RobinBaruffa/omniPTT-hardware/Kicad_import_LCSC.md

easyeda2kicad --full --lcsc_id=XXXXXXX --output /home/robin/Projects/OmniPTT/hardware/libraries/Project_components.kicad_sym
