RobinBaruffa/omniPTT-hardware/ptt_board/ptt_board_core/exports/3D_model/ptt_board_core.step

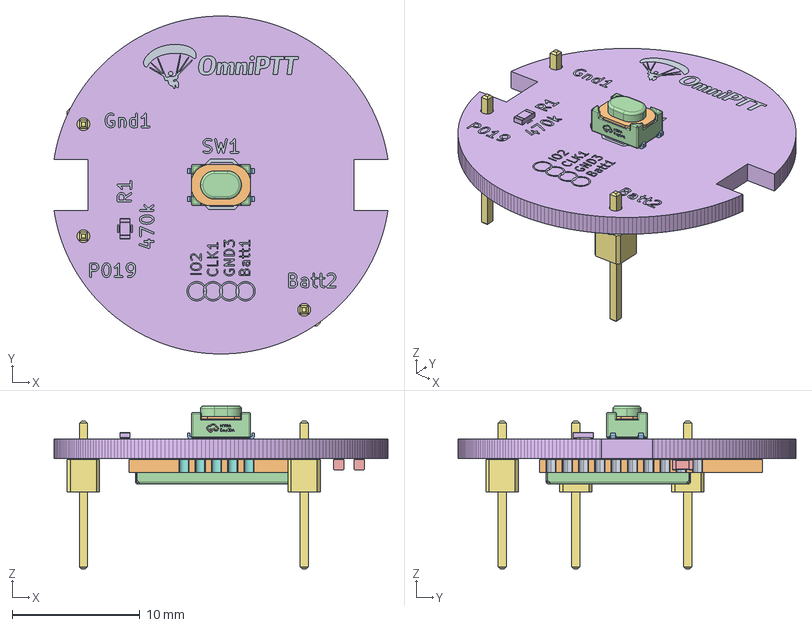
[picture p1: CAD file, 2026-05-04]
ptt_board/ptt_board_core/exports/3D_model/ptt_board_core.step
26.1 x 26.4 x 12.7 mm
SW-SMD_4P-L4.2-W3.2-P2.15-LS4.6
R_0603_1608Metric
PinHeader_1x01_P2.54mm_Vertical x 3
SKB369
C_0603_1608Metric x 2
ptt_board_core_silkscreen x 2
ptt_board_core_PCB
