RobinBaruffa/omniPTT-hardware/radio_board/exports/3D_model/ptt_board_cell.step

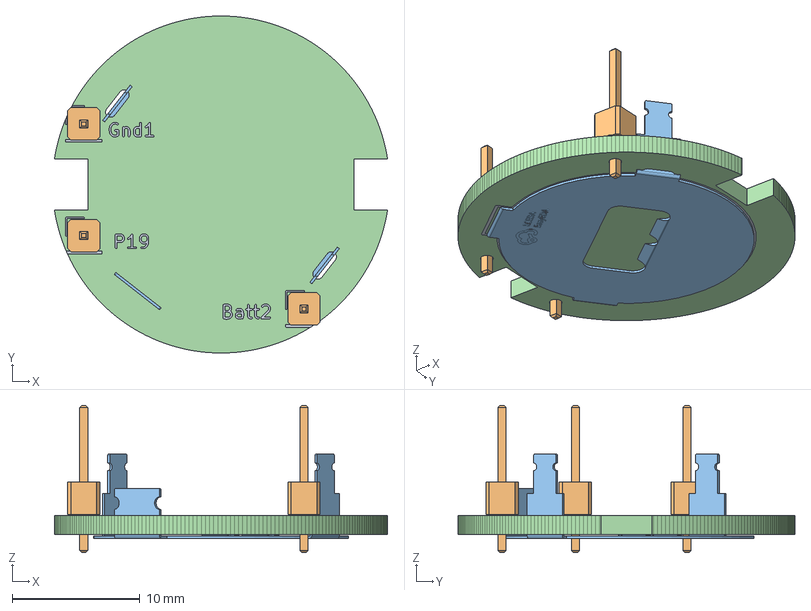
[picture p2: CAD file, 2026-05-04]
radio_board/exports/3D_model/ptt_board_cell.step
26.1 x 26.4 x 11.5 mm
PinHeader_1x01_P2.54mm_Vertical x 3
BATT-TH_MY-2032-02
ptt_board_cell_silkscreen x 2
ptt_board_cell_PCB
