RobinBaruffa/omniPTT-hardware/ptt_board/ptt_board_core/ptt_board_core.kicad_pcb

## KiCad design ptt_board/ptt_board_core/ptt_board_core.kicad_pcb (2026-05-04)

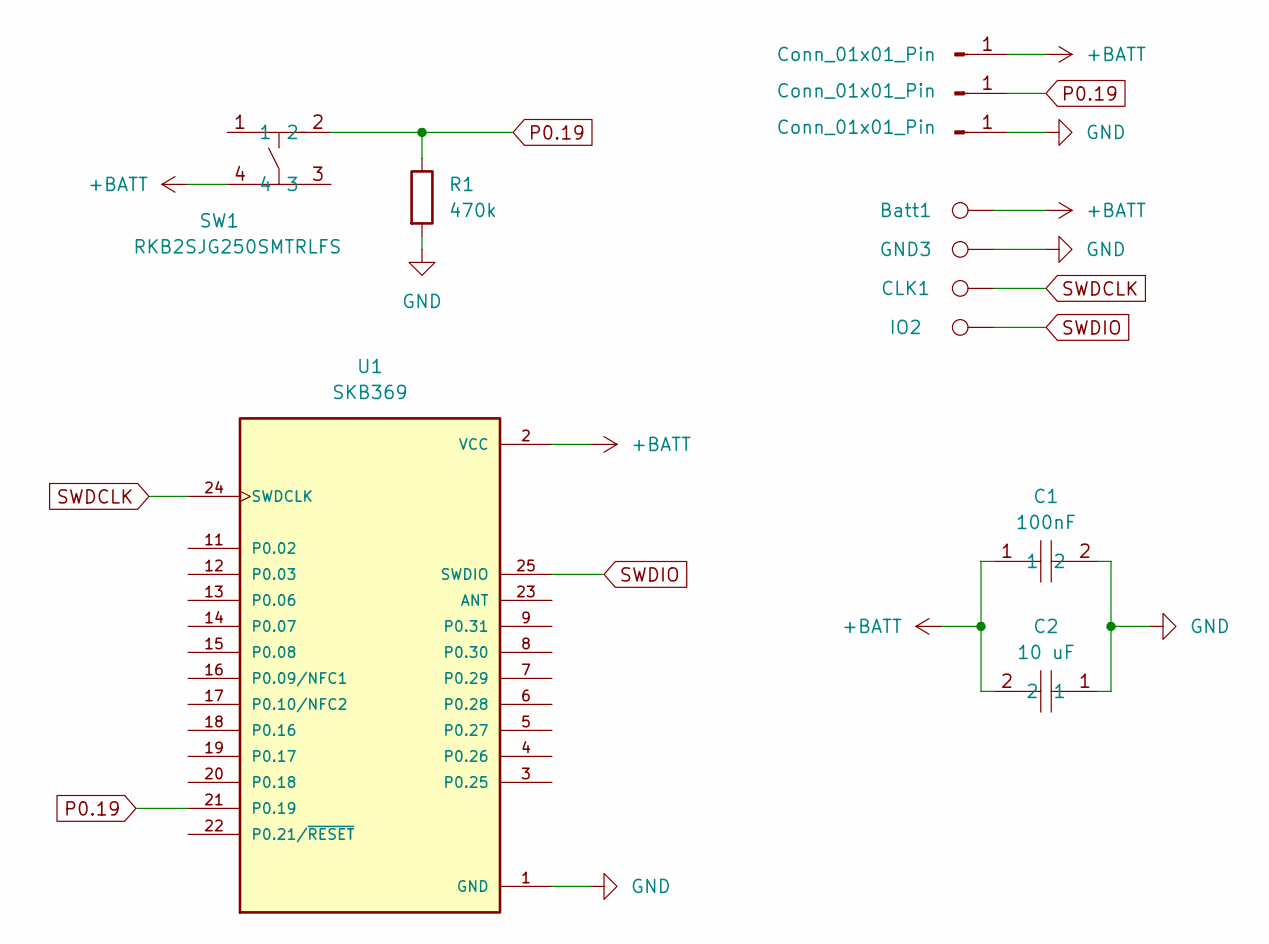
[picture p3: schematic ptt_board_core.kicad_sch]

Parts:
Batt1: TestPoint; TestPoint_Pad_D1.0mm
Batt2: Conn_01x01_Pin; PinHeader_1x01_P2.54mm_Vertical
C1: 100nF; C_0603_1608Metric_Pad1.08x0.95mm_HandSolder; LCSC Part C14663
C2: 10 uF; C_0603_1608Metric_Pad1.08x0.95mm_HandSolder; LCSC Part C14663
CLK1: TestPoint; TestPoint_Pad_D1.0mm
GND3: TestPoint; TestPoint_Pad_D1.0mm
Gnd1: Conn_01x01_Pin; PinHeader_1x01_P2.54mm_Vertical
IO2: TestPoint; TestPoint_Pad_D1.0mm
P019: Conn_01x01_Pin; PinHeader_1x01_P2.54mm_Vertical
R1: 470k; R_0603_1608Metric_Pad0.98x0.95mm_HandSolder; LCSC Part C114622
SW1: RKB2SJG250SMTRLFS; Push button C2927788; LCSC Part C2927788
U1: SKB369; SKYLAB_SKB369; PART_REV V1.03

Connections:
+BATT: Batt1.1, Batt2.1, C1.1, C2.2, SW1.4, U1.2 (VCC)
GND: C1.2, C2.1, GND3.1, Gnd1.1, R1.2, U1.1 (GND), U1.10 (GND)
P0.19: P019.1, R1.1, SW1.2, U1.21 (P0.19)
SWDCLK: CLK1.1, U1.24 (SWDCLK)
SWDIO: IO2.1, U1.25 (SWDIO)

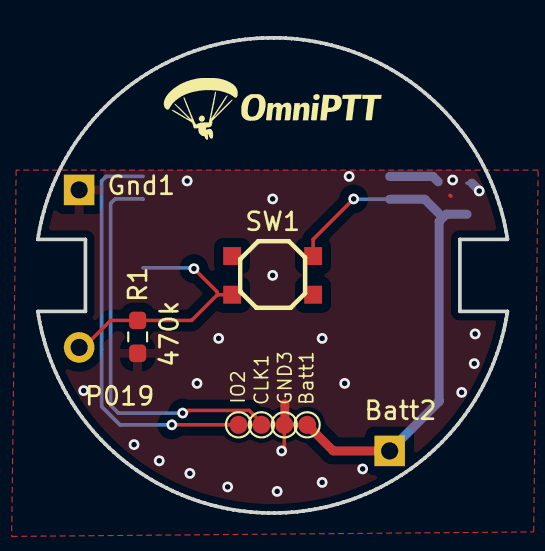
[picture p4: board ptt_board_core.kicad_pcb from above]

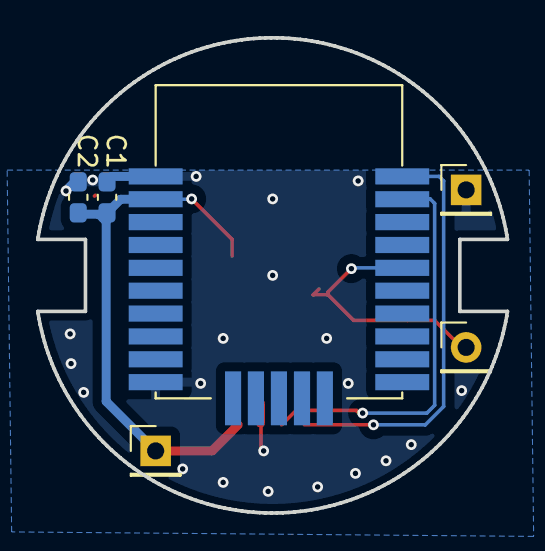
[picture p5: board ptt_board_core.kicad_pcb from below]

Board: 2 copper layers, 26.1 x 26.4 mm, 12 parts (6 on the bottom side), 5 nets.
