RobinBaruffa/omniPTT-hardware/radio_board/radio_board.kicad_pcb

## KiCad design radio_board/radio_board.kicad_pcb (2026-05-04)

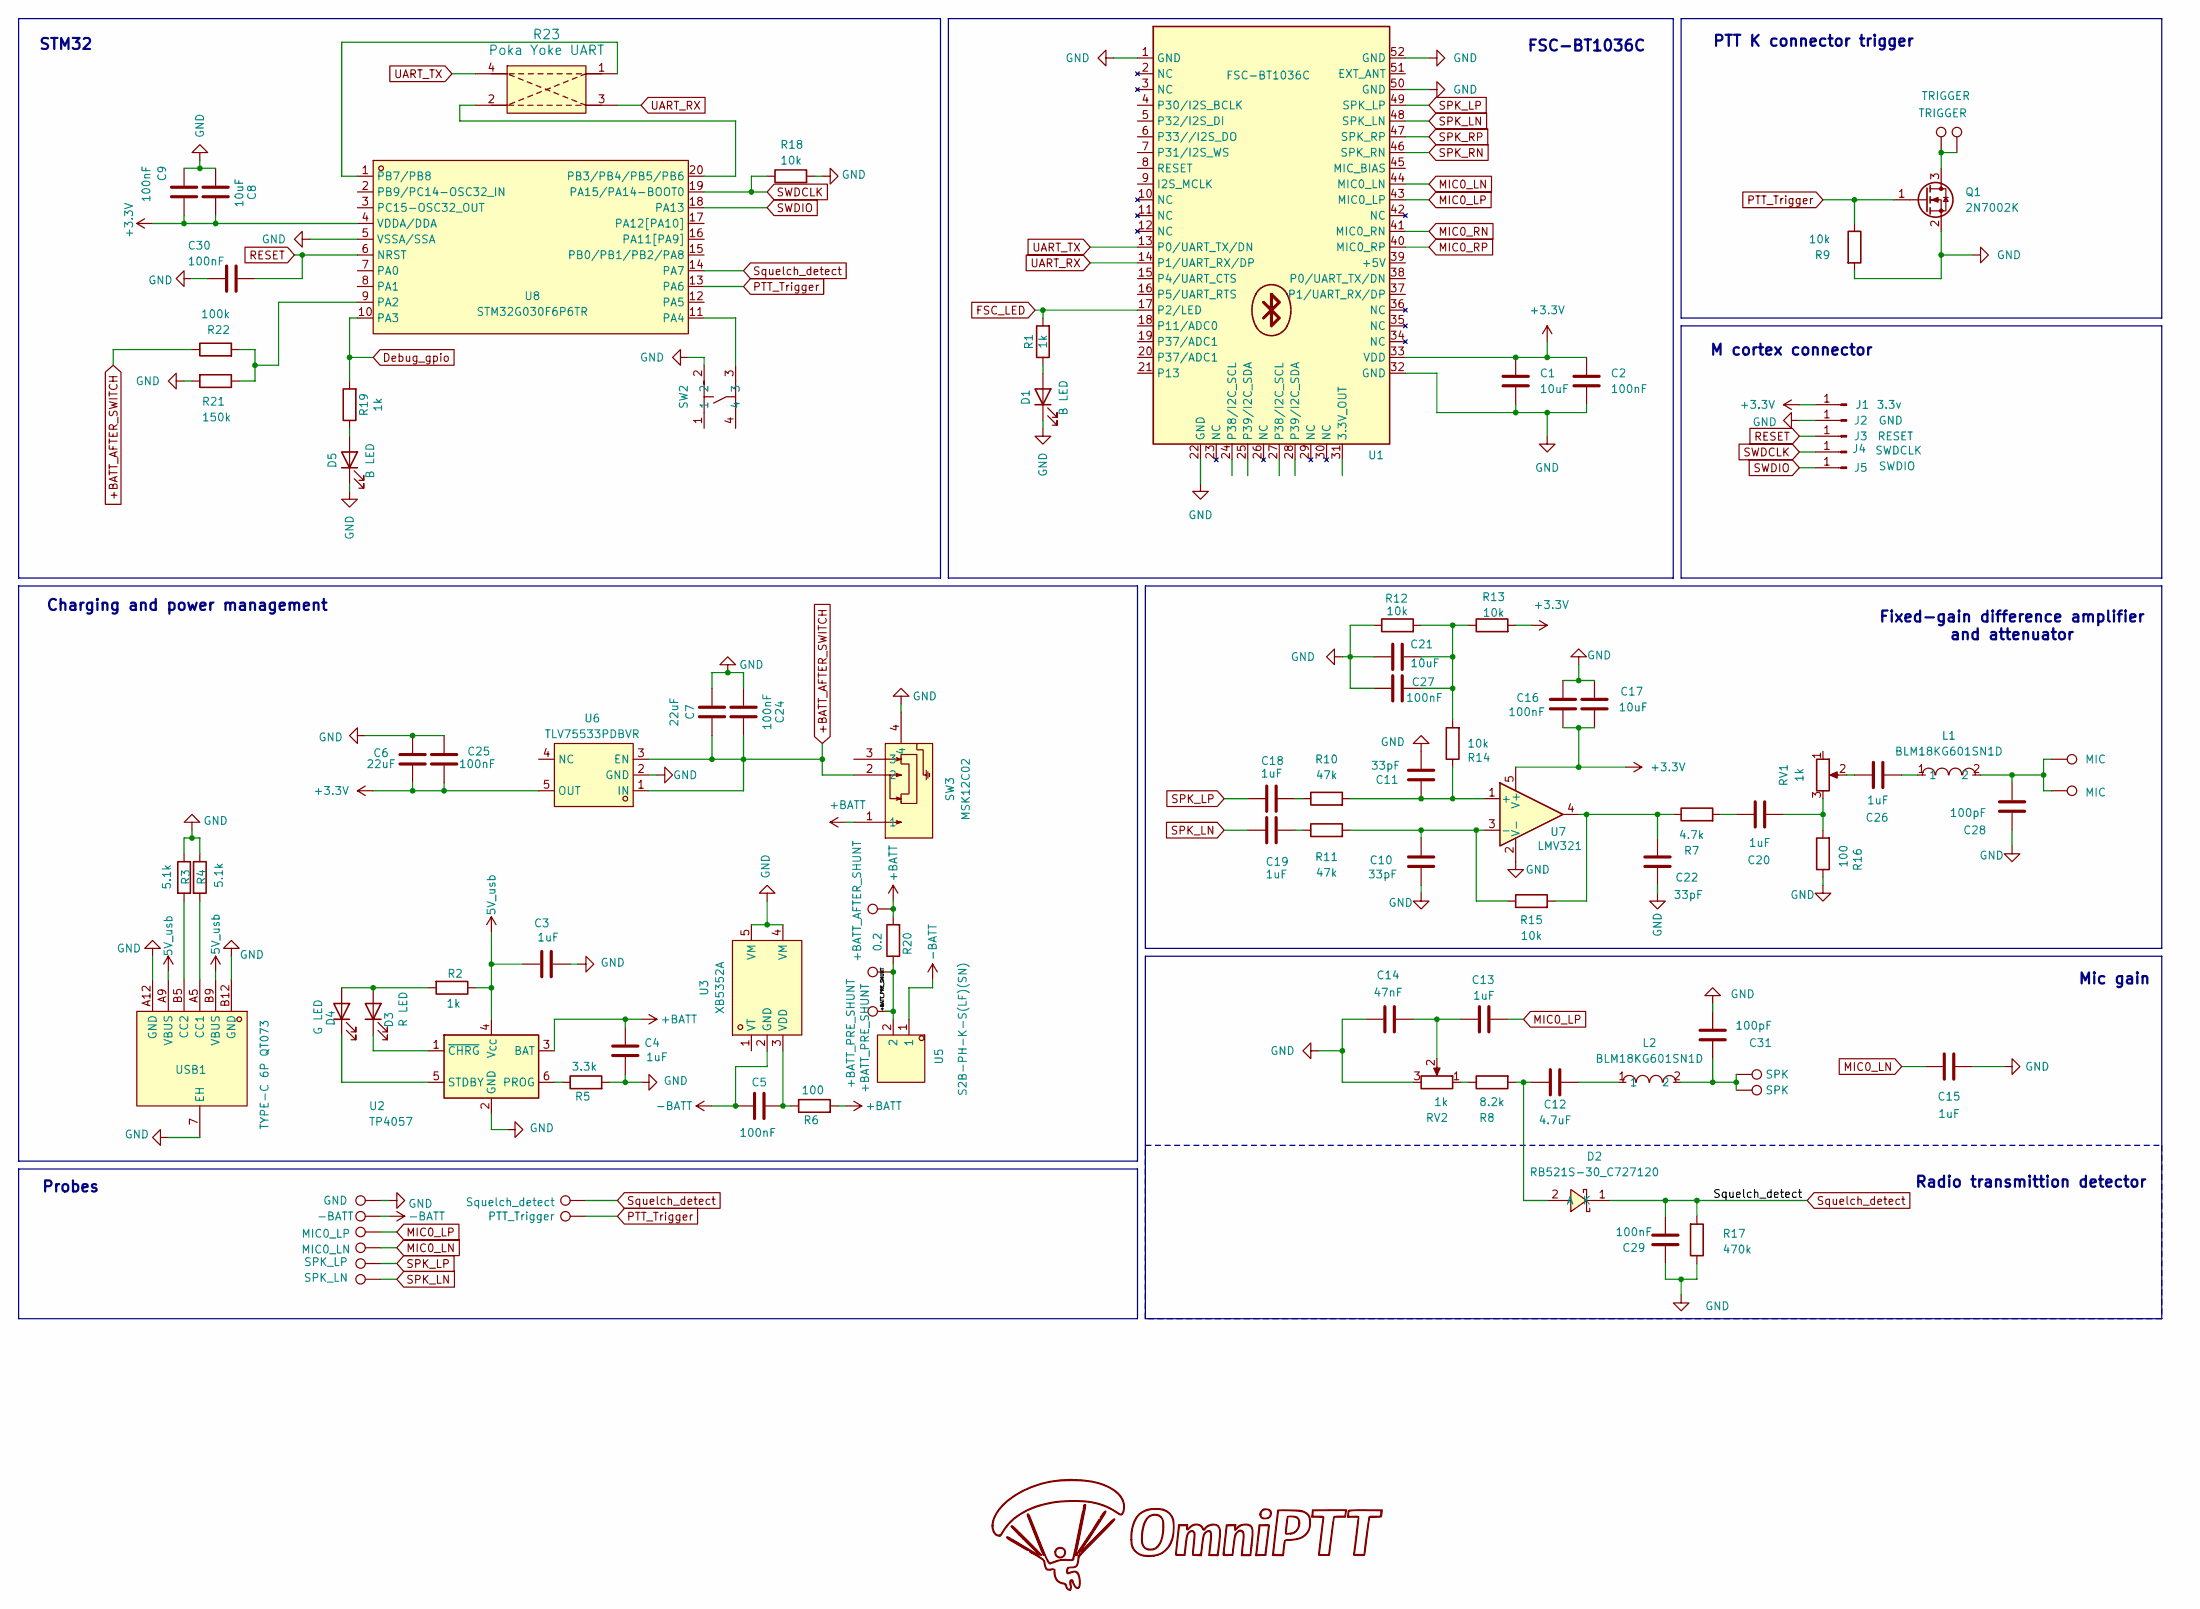
[picture p6: schematic radio_board.kicad_sch]

Parts:
C1, C8, C17, C21: 10uF; R_0603_1608Metric_Pad0.98x0.95mm_HandSolder
C2, C5, C9, C16, C24, C25, C27, C29, C30: 100nF; R_0603_1608Metric_Pad0.98x0.95mm_HandSolder
C3, C4, C13, C15, C18, C19, C20, C26: 1uF; R_0603_1608Metric_Pad0.98x0.95mm_HandSolder
C6, C7: 22uF; R_0805_2012Metric_Pad1.20x1.40mm_HandSolder; LCSC Part C602037
C10, C11, C22: 33pF; R_0603_1608Metric_Pad0.98x0.95mm_HandSolder; LCSC Part C107047
C12: 4.7uF; R_0603_1608Metric_Pad0.98x0.95mm_HandSolder
C14: 47nF; R_0603_1608Metric_Pad0.98x0.95mm_HandSolder; LCSC Part C107093
C28, C31: 100pF; R_0603_1608Metric_Pad0.98x0.95mm_HandSolder; LCSC Part C14665
D1, D5: B LED; LED_0603_1608Metric_Pad1.05x0.95mm_HandSolder
D2: RB521S-30_C727120; SOD-523_L1.2-W0.8-LS1.6-RD; MPN RB521S-30; LCSC Part C727120
D3: R LED; LED_0603_1608Metric_Pad1.05x0.95mm_HandSolder
D4: G LED; LED_0603_1608Metric_Pad1.05x0.95mm_HandSolder
J1: 3.3v; PinHeader_1x01_P2.54mm_Vertical
J2: GND; PinHeader_1x01_P2.54mm_Vertical
J3: RESET; PinHeader_1x01_P2.54mm_Vertical
J4: SWDCLK; PinHeader_1x01_P2.54mm_Vertical
J5: SWDIO; PinHeader_1x01_P2.54mm_Vertical
L1, L2: BLM18KG601SN1D; L0603; MPN BLM18KG601SN1D; LCSC Part C85833
Q1: 2N7002K; SOT-23
R1, R2, R19: 1k; R_0603_1608Metric_Pad0.98x0.95mm_HandSolder
R3, R4: 5.1k; R_0603_1608Metric_Pad0.98x0.95mm_HandSolder
R5: 3.3k; R_0603_1608Metric_Pad0.98x0.95mm_HandSolder
R6, R16: 100; R_0603_1608Metric_Pad0.98x0.95mm_HandSolder
R7: 4.7k; R_0603_1608Metric_Pad0.98x0.95mm_HandSolder; LCSC Part C99782
R8: 8.2k; R_0603_1608Metric_Pad0.98x0.95mm_HandSolder
R9, R12, R13, R14, R15, R18: 10k; R_0603_1608Metric_Pad0.98x0.95mm_HandSolder
R10, R11: 47k; R_0603_1608Metric_Pad0.98x0.95mm_HandSolder; LCSC Part C105579
R17: 470k; R_0603_1608Metric_Pad0.98x0.95mm_HandSolder; LCSC Part C114622
R20: 0.2; R_0603_1608Metric_Pad0.98x0.95mm_HandSolder; LCSC Part C723543
R21: 150k; R_0603_1608Metric_Pad0.98x0.95mm_HandSolder; LCSC Part C114660
R22: 100k; R_0603_1608Metric_Pad0.98x0.95mm_HandSolder; LCSC Part C14675
R23: Poka Yoke UART; poka_yoke_uart_Solder
RV1, RV2: 1k; Potentiometer_Bourns_3296W_Vertical
SW2: RKB2SJG250SMTRLFS; SW-SMD_4P-L4.2-W3.2-P2.15-LS4.6; LCSC Part C2927788
SW3: MSK12C02; SW-TH_MSK12C02; LCSC Part C431540
TP1, TP47: +BATT_PRE_SHUNT; TestPoint_THTPad_D2.0mm_Drill1.0mm
TP2: PTT_Trigger; TestPoint_THTPad_D2.0mm_Drill1.0mm
TP3: +BATT_AFTER_SHUNT; TestPoint_THTPad_D2.0mm_Drill1.0mm
TP5: GND; TestPoint_THTPad_D2.0mm_Drill1.0mm
TP6: -BATT; TestPoint_THTPad_D2.0mm_Drill1.0mm
TP14, TP43: TRIGGER; TestPoint_THTPad_D2.0mm_Drill1.0mm
TP20, TP45: SPK; TestPoint_THTPad_D2.0mm_Drill1.0mm
TP33: SPK_LP; TestPoint_THTPad_D2.0mm_Drill1.0mm
TP34: SPK_LN; TestPoint_THTPad_D2.0mm_Drill1.0mm
TP38: MIC0_LP; TestPoint_THTPad_D2.0mm_Drill1.0mm
TP44: Squelch_detect; TestPoint_THTPad_D2.0mm_Drill1.0mm
TP49: MIC0_LN; TestPoint_THTPad_D2.0mm_Drill1.0mm
TP50, TP51: MIC; TestPoint_THTPad_D2.0mm_Drill1.0mm
U1: FSC-BT1036C
U2: TP4057; SOT-23-6
U3: XB5352A; SOT-23-5; LCSC Part C154943
U5: S2B-PH-K-S(LF)(SN); CONN-TH_S2B-PH-K-S-LF-SN; LCSC Part C173752
U6: TLV75533PDBVR; SOT-23-5_L3.0-W1.7-P0.95-LS2.8-BR; MPN TLV75533PDBVR; LCSC Part C404027
U7: LMV321; SOT-23-5_HandSoldering; LCSC Part C7972
U8: STM32G030F6P6TR; TSSOP-20_L6.5-W4.4-P0.65-LS6.4-BL; MPN STM32G030F6P6TR; LCSC Part C529330
USB1: TYPE-C 6P QT073; USB-C-SMD_TYPE-C-6P-QT073; LCSC Part C2681548

Connections:
5V_usb: C3.2, R2.1, U2.4 (V_{CC}), USB1.A9 (VBUS), USB1.B9 (VBUS)
+3.3V: C1.2, C2.2, C6.2, C8.2, C9.2, C16.2, C17.2, C25.2, J1.1, R13.2, U1.33 (VDD), U6.5 (OUT), U7.5 (V+), U8.4 (VDDA/DDA)
+BATT: C4.1, R6.2, R20.2, SW3.1, TP3.1, U2.3 (BAT)
+BATT_AFTER_SWITCH: C7.2, C24.2, R22.1, SW3.2, U6.1 (IN), U6.3 (EN)
-BATT: C5.1, TP6.1, U3.2 (GND), U5.1
/+BATT_PRE_SHUNT: R20.1, TP1.1, TP47.1, U5.2
Debug_gpio: R19.2, U8.10 (PA3)
FSC_LED: R1.2, U1.17 (P2/LED)
GND: C1.1, C2.1, C3.1, C4.2, C6.1, C7.1, C8.1, C9.1, C10.2, C11.2, C14.1, C15.1, C16.1, C17.1, C21.1, C22.1, C24.1, C25.1, C27.1, C28.2, C29.2, C30.2, C31.1, D1.1 (K), D5.1 (K), J2.1, Q1.2 (S), R3.1, R4.1, R5.2, R9.2, R12.1, R16.1, R17.1, R18.2, R21.2, RV2.3, SW2.2, SW3.4, TP5.1, U1.1 (GND), U1.22 (GND), U1.32 (GND), U1.50 (GND), U1.52 (GND), U2.2 (GND), U3.4 (VM), U3.5 (VM), U6.2 (GND), U7.2 (V-), U8.5 (VSSA/SSA), USB1.7 (EH), USB1.A12 (GND), USB1.B12 (GND)
MIC0_LN: C15.2, TP49.1, U1.44 (MIC0_LN)
MIC0_LP: C13.2, TP38.1, U1.43 (MIC0_LP)
MIC0_RN: U1.41 (MIC0_RN)
MIC0_RP: U1.40 (MIC0_RP)
unnamed: C12.1, L2.1
unnamed: C13.1, C14.2, RV2.2
unnamed: C18.1, R10.1
unnamed: C19.1, R11.1
unnamed: C20.1, R7.2
unnamed: C20.2, R16.2, RV1.3
unnamed: C21.2, C27.2, R12.2, R13.1, R14.2
unnamed: C22.2, R7.1, R15.2, U7.4
unnamed: C26.1, RV1.2
unnamed: C26.2, L1.1
unnamed: C28.1, L1.2, TP50.1, TP51.1
unnamed: C31.2, L2.2, TP20.1, TP45.1
unnamed: D1.2 (A), R1.1
unnamed: C12.2, D2.2 (A), R8.2
unnamed: D3.2 (A), D4.2 (A), R2.2
unnamed: D3.1 (K), U2.1 (~CHRG)
unnamed: D4.1 (K), U2.5 (STDBY)
unnamed: D5.2 (A), R19.1
unnamed: Q1.3 (D), TP14.1, TP43.1
unnamed: R8.1, RV2.1
unnamed: R5.1, U2.6 (PROG)
unnamed: C5.2, R6.1, U3.3 (VDD)
unnamed: C11.1, R10.2, R14.1, U7.1 (+)
unnamed: C10.1, R11.2, R15.1, U7.3 (-)
unnamed: R21.1, R22.2, U8.9 (PA2)
unnamed: SW2.3, U8.11 (PA4)
unnamed: R23.2, U8.20 (PB3/PB4/PB5/PB6)
unnamed: R23.1, U8.1 (PB7/PB8)
unnamed: R4.2, USB1.A5 (CC1)
unnamed: R3.2, USB1.B5 (CC2)
PTT_Trigger: Q1.1 (G), R9.1, TP2.1, U8.13 (PA6)
RESET: C30.1, J3.1, U8.6 (NRST)
SPK_LN: C19.2, TP34.1, U1.48 (SPK_LN)
SPK_LP: C18.2, TP33.1, U1.49 (SPK_LP)
SPK_RN: U1.46 (SPK_RN)
SPK_RP: U1.47 (SPK_RP)
SWDCLK: J4.1, R18.1, U8.19 (PA15/PA14-BOOT0)
SWDIO: J5.1, U8.18 (PA13)
Squelch_detect: C29.1, D2.1 (K), R17.2, TP44.1, U8.14 (PA7)
UART_RX: R23.3, U1.14 (P1/UART_RX/DP)
UART_TX: R23.4, U1.13 (P0/UART_TX/DN)

Notes on the sheet:
Charging and power management
Fixed-gain difference amplifier and attenuator
Probes
STM32
M cortex connector
Radio transmittion detector
PTT K connector trigger
FSC-BT1036C
Mic gain

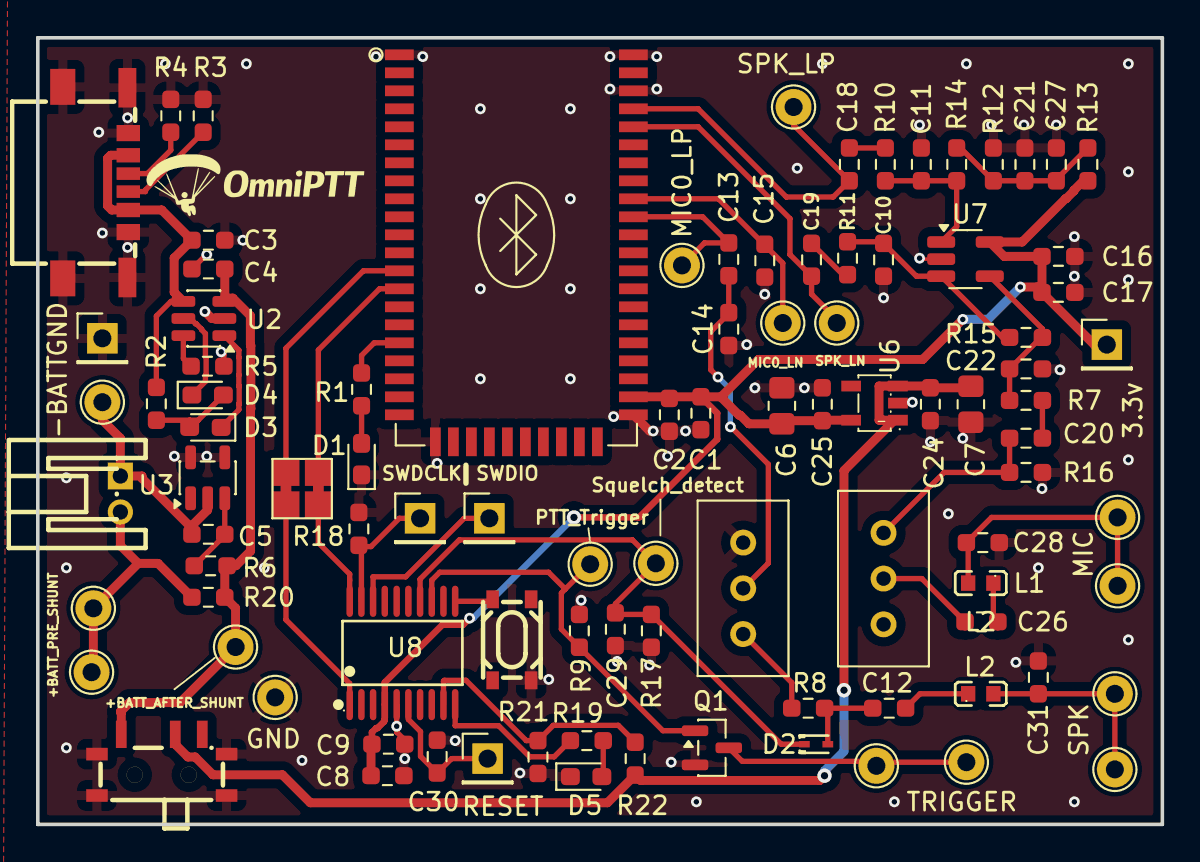
[picture p7: board radio_board.kicad_pcb from above]

Board: 2 copper layers, 62.5 x 43.7 mm, 95 parts (0 on the bottom side), 50 nets.
