RobinBaruffa/omniPTT-hardware/ptt_board/ptt_board_cell/ptt_board_cell.kicad_pcb

## KiCad design ptt_board/ptt_board_cell/ptt_board_cell.kicad_pcb (2026-05-04)

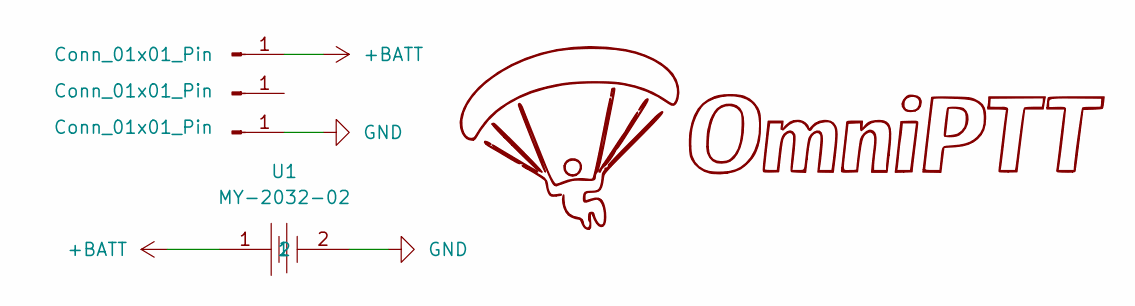
[picture p8: schematic ptt_board_cell.kicad_sch]

Parts:
Batt2: Conn_01x01_Pin; PinHeader_1x01_P2.54mm_Vertical
Gnd1: Conn_01x01_Pin; PinHeader_1x01_P2.54mm_Vertical
P19: Conn_01x01_Pin; PinHeader_1x01_P2.54mm_Vertical
U1: MY-2032-02; BATT-TH_MY-2032-02; MPN MY-2032-02; LCSC Part C964822

Connections:
+BATT: Batt2.1, U1.1
GND: Gnd1.1, U1.2

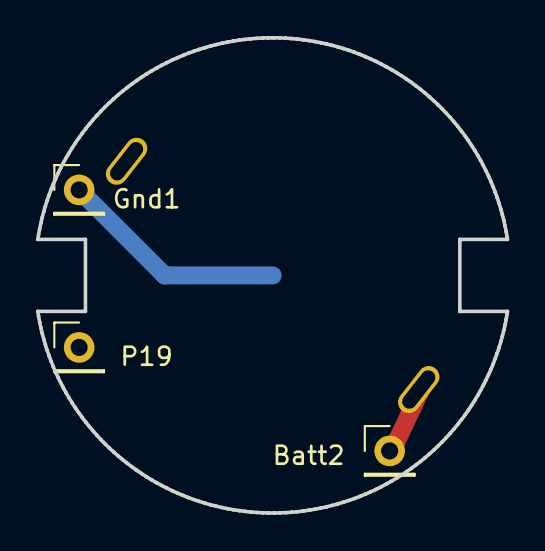
[picture p9: board ptt_board_cell.kicad_pcb from above]

Board: 2 copper layers, 26.1 x 26.4 mm, 4 parts (1 on the bottom side), 2 nets.
