RobinBaruffa/omniPTT-hardware/ptt_board/ptt_board_debug/ptt_board_debug.kicad_pcb

## KiCad design ptt_board/ptt_board_debug/ptt_board_debug.kicad_pcb (2026-04-28)

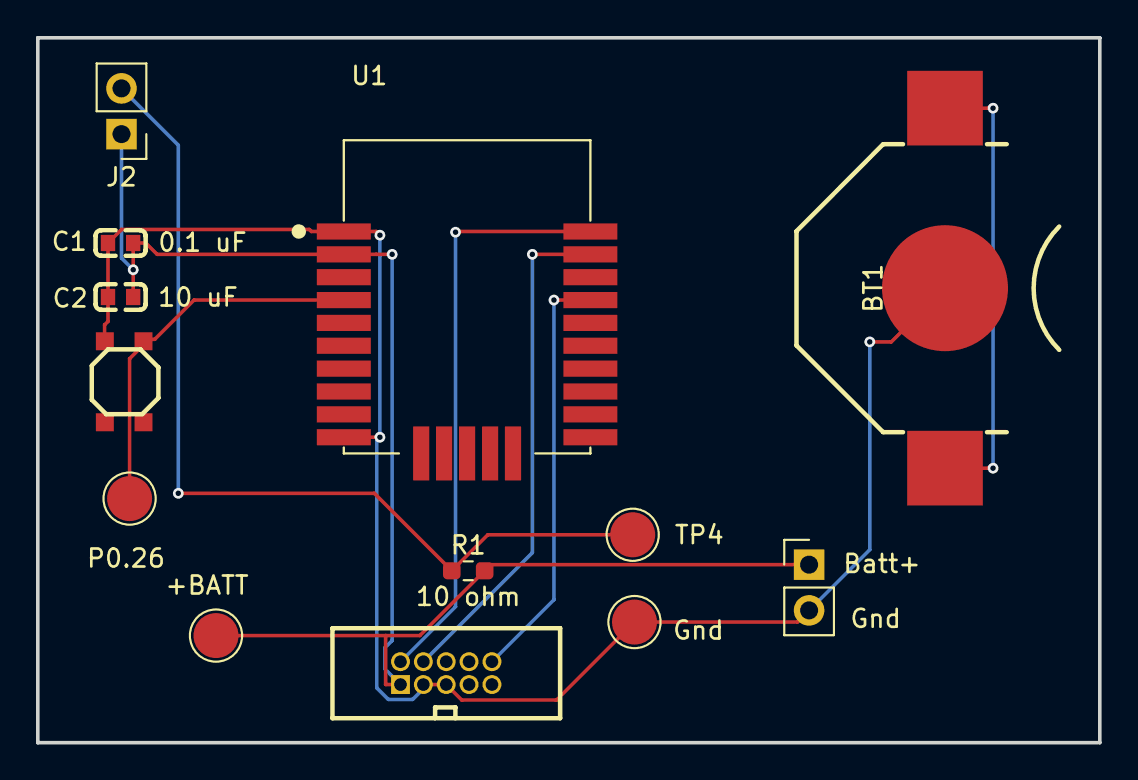
[picture p10: board ptt_board_debug.kicad_pcb from above]

Board: 2 copper layers, 59.0 x 39.2 mm, 12 parts (0 on the bottom side), 7 nets.

Parts:
+BATT: TestPoint; TestPoint_Pad_D2.5mm
BT1: MY-1632-03-R; BAT-SMD_MY-1632-03
C1: 0.1 uF; C0603
C2: 10 uF; C0603
CN1: HX JN1.27-2X5P ZZ H4.9; CONN-TH_10P-P1.27_HX-JN1.27-2X5P-ZZ-H4.9
J1, J2: Conn_01x02_Pin; PinHeader_1x02_P2.54mm_Vertical
P0.26: TestPoint; TestPoint_Pad_D2.5mm
R1: 10 ohm; R_0603_1608Metric_Pad0.98x0.95mm_HandSolder
TP2, TP4: TestPoint; TestPoint_Pad_D2.5mm
U1: SKB369; SKYLAB_SKB369

Connections:
+BATT: +BATT.1, C1.1, C2.2, CN1.1, J1.1, J2.1, R1.2, U1.2 (VCC)
GND: BT1.2, C1.2, C2.1, CN1.3, CN1.5, J1.2, TP2.1, U1.1 (GND), U1.10 (GND)
unnamed: J2.2, R1.1, TP4.1
unnamed: P0.26.1, U1.4 (P0.26)
Reset: CN1.10, U1.22 (P0.21/~RESET)
SWDCLK: CN1.4, U1.24 (SWDCLK)
SWDIO: CN1.2, U1.25 (SWDIO)
