RobinBaruffa/omniPTT-hardware/(commit log)

2026-04-07 [Initial] Initial commit
    [ptt_board_button.kicad_pcb, ptt_board_button.kicad_sch, ptt_board_core.kicad_pcb, ptt_board_core.kicad_sch, ptt_board_debug.kicad_pcb, radio_board.kicad_pcb, radio_board.kicad_sch]
2026-04-16 [Feature] WIP radio board
    [radio_board.kicad_sch]
2026-04-16 [feature fix] Add a proper op amp for radio module
    [radio_board.kicad_sch]
2026-04-20 [Feature] Rework pcb, better ldo, more filtering
    [radio_board.kicad_sch]
2026-04-20 [WIP] Started net rev of ptt board and radio board
    [PTT_PCB_v4_radio_module.step, ptt_board_button.kicad_pcb, ptt_board_cell.kicad_pcb, ptt_board_cell.kicad_sch, ptt_board_core.kicad_pcb, ptt_board_core.kicad_sch, radio_board.kicad_sch]
2026-04-28 [Housekeeping] Renamed project library
    [freerouting.dsn, ptt_board_cell.kicad_pcb, ptt_board_cell.kicad_sch, ptt_board_core.kicad_pcb, ptt_board_core.kicad_sch, ptt_board_debug.kicad_pcb, radio_board.kicad_pcb, radio_board.kicad_sch]
2026-05-03 [Feature] Cleaned up PCB and schematics. Add logo, checked schematic, layout and wiring
    [ptt_board_cell.kicad_pcb, ptt_board_core.kicad_pcb, ptt_board_core.kicad_sch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]
2026-05-04 [Feature] Add ferrite and cap
    [radio_board.kicad_pcb, radio_board_BOM.csv, radio_board_BOM.ods]
2026-05-04 [Milestone] Last commit before pourchasing v2
    [ptt_board_cell.kicad_pcb, ptt_board_cell.kicad_sch, ptt_board_cell.step, ptt_board_core.kicad_pcb, ptt_board_core.kicad_sch, ptt_board_core.step, radio_board.kicad_pcb, radio_board.kicad_sch]
2026-05-19 [Fix] Changed a resistor value to lower attenuation of baofeng MIC in
    [radio_board.kicad_sch, radio_board_BOM.csv]
